isamed93/macropad_4x4_promicro/README.md

# macropad_4x4_promicro
Project for the second version of the 4x4 macropad, which uses a promicro instead of an onboard MCU
