isamed93/macropad_4x4_promicro/streamdeck2.sch

## KiCad design streamdeck2.sch (2022-08-13)

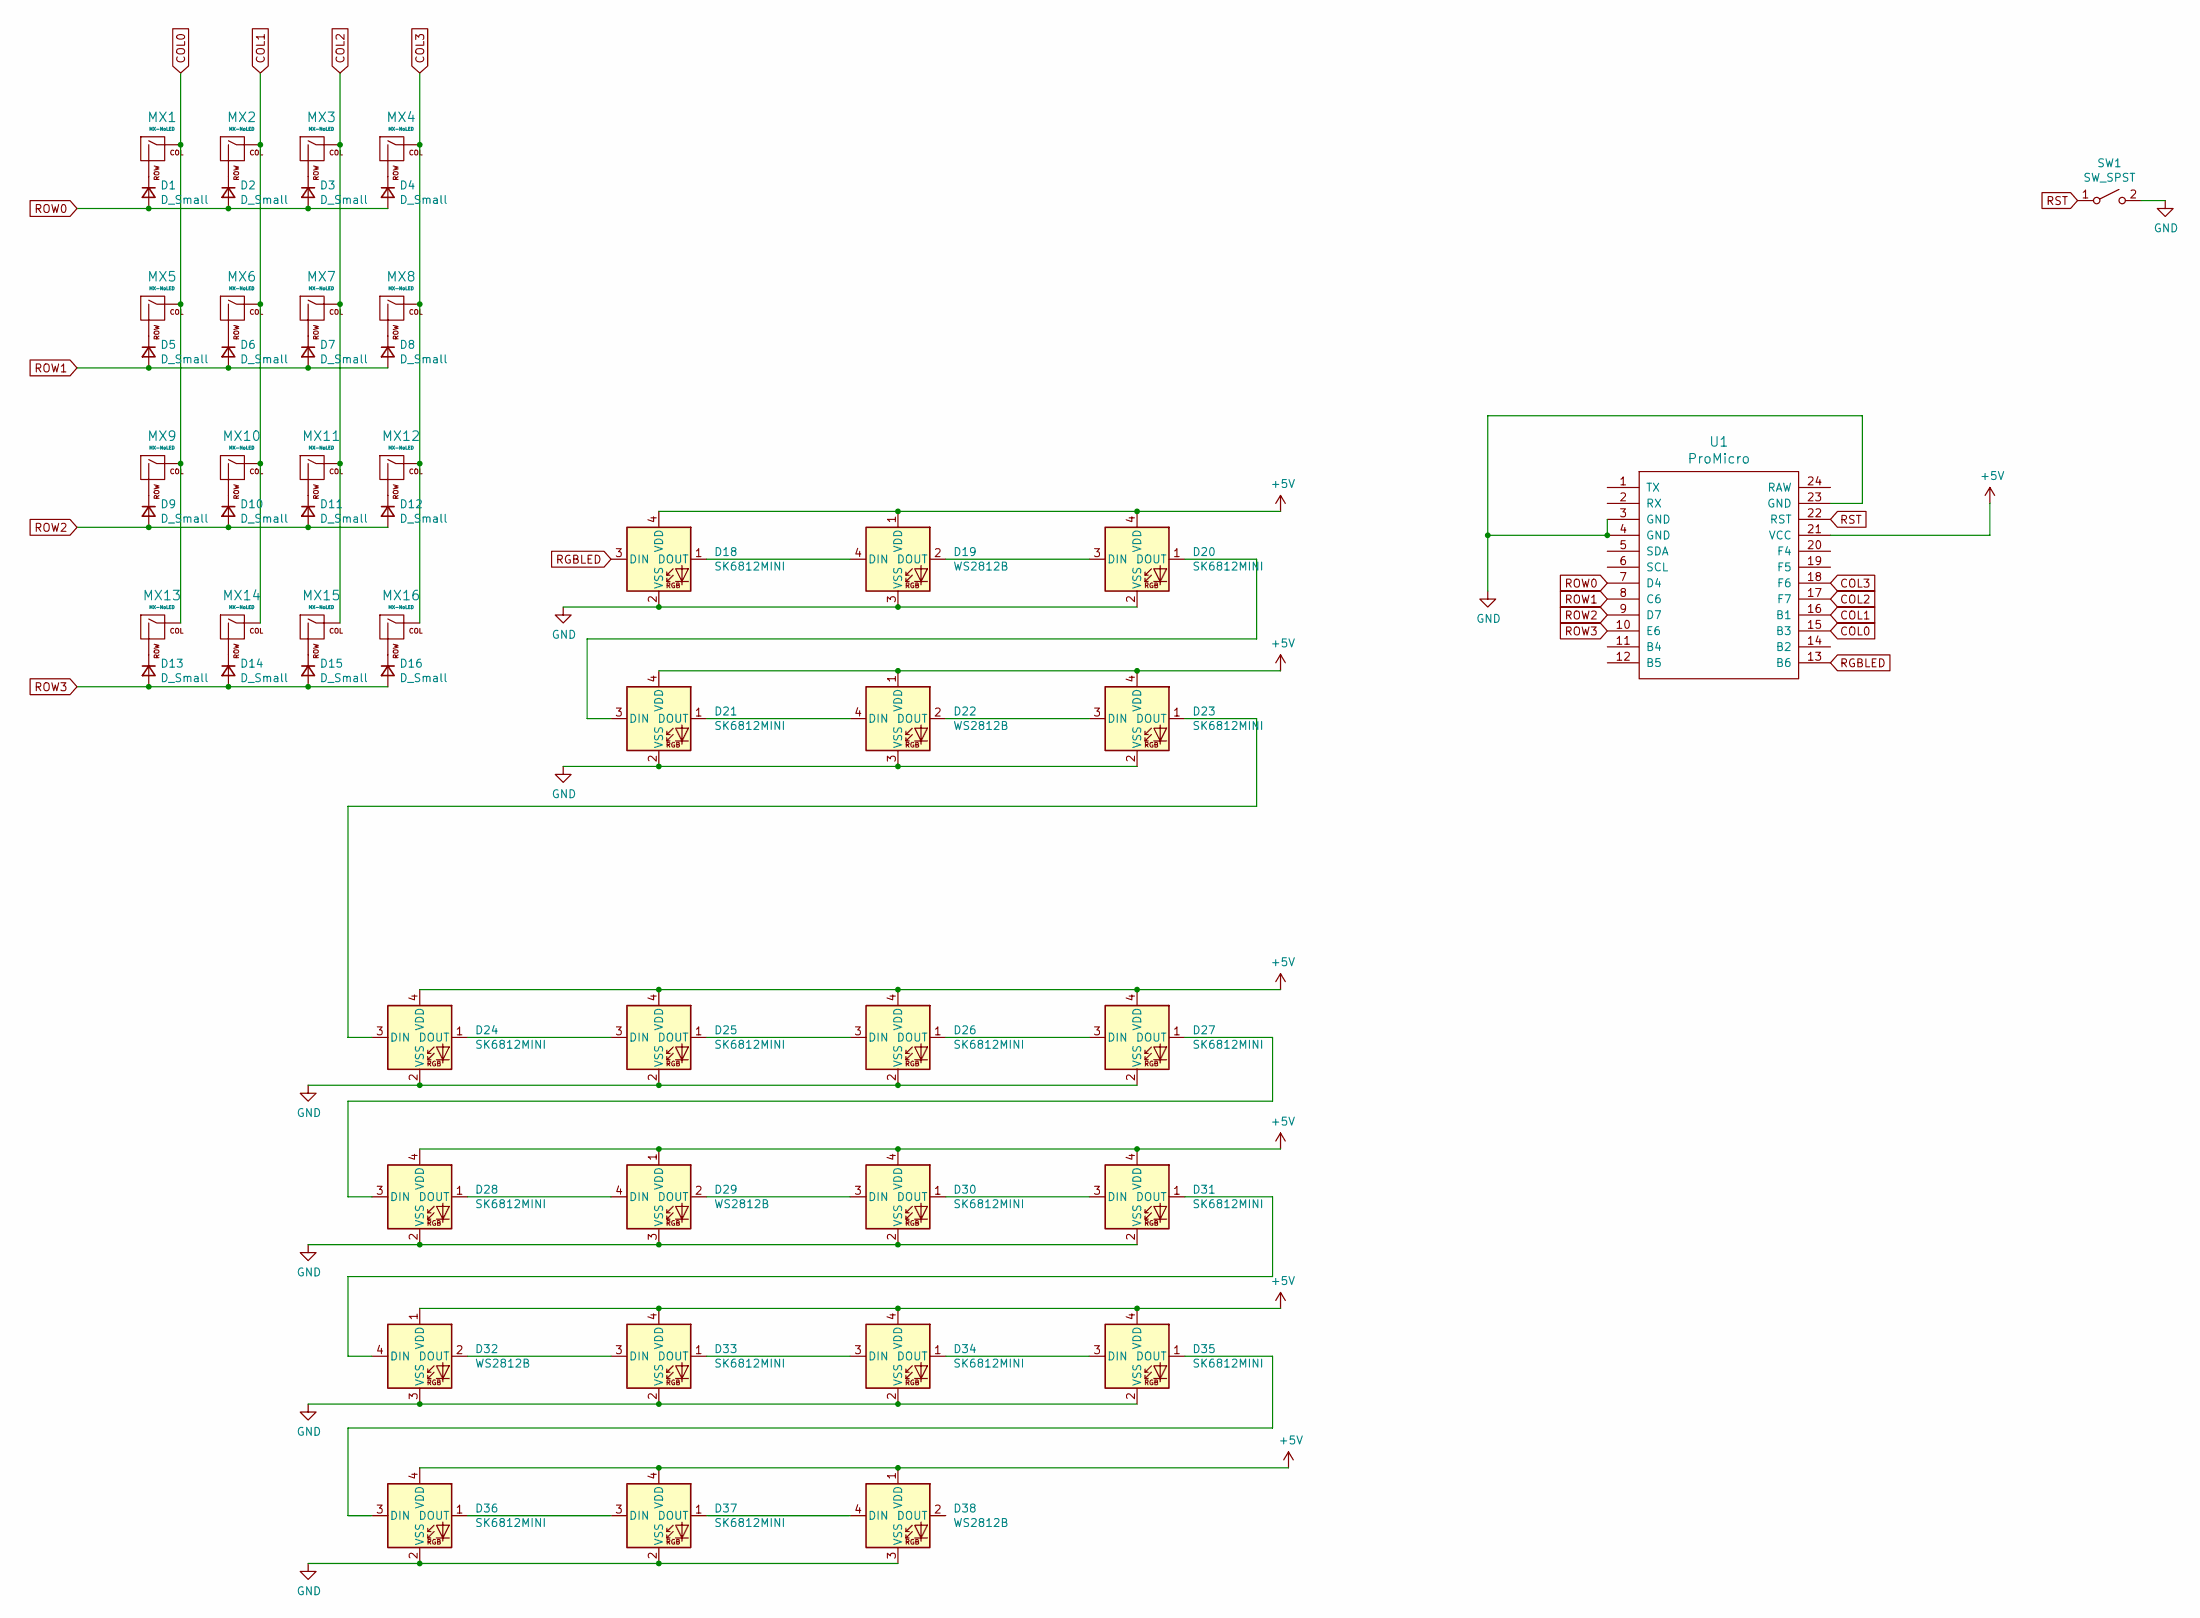
[picture p1: schematic streamdeck2.sch]

Parts:
D1, D2, D3, D4, D5, D6, D7, D8, D9, D10, D11, D12, D13, D14, D15, D16: D_Small; D_SOD-123
D18, D20, D21, D23, D24, D25, D26, D27, D28, D30, D31, D33, D34, D35, D36, D37: SK6812MINI; YS-SK6812MINI-E
D19, D22, D29, D32, D38: WS2812B; LED_WS2812B_PLCC4_5.0x5.0mm_P3.2mm
MX1, MX2, MX3, MX4, MX5, MX6, MX7, MX8, MX9, MX10, MX11, MX12, MX13, MX14, MX15, MX16: MX-NoLED; MXOnly-1U-Hotswap
SW1: SW_SPST; SW_SPST_TL3342
U1: ProMicro

Connections:
+5V: D18.4 (VDD), D19.1 (VDD), D20.4 (VDD), D21.4 (VDD), D22.1 (VDD), D23.4 (VDD), D24.4 (VDD), D25.4 (VDD), D26.4 (VDD), D27.4 (VDD), D28.4 (VDD), D29.1 (VDD), D30.4 (VDD), D31.4 (VDD), D32.1 (VDD), D33.4 (VDD), D34.4 (VDD), D35.4 (VDD), D36.4 (VDD), D37.4 (VDD), D38.1 (VDD), U1.21 (VCC)
COL0: MX1.1 (COL), MX5.1 (COL), MX9.1 (COL), MX13.1 (COL), U1.15 (B3)
COL1: MX2.1 (COL), MX6.1 (COL), MX10.1 (COL), MX14.1 (COL), U1.16 (B1)
COL2: MX3.1 (COL), MX7.1 (COL), MX11.1 (COL), MX15.1 (COL), U1.17 (F7)
COL3: MX4.1 (COL), MX8.1 (COL), MX12.1 (COL), MX16.1 (COL), U1.18 (F6)
GND: D18.2 (VSS), D19.3 (VSS), D20.2 (VSS), D21.2 (VSS), D22.3 (VSS), D23.2 (VSS), D24.2 (VSS), D25.2 (VSS), D26.2 (VSS), D27.2 (VSS), D28.2 (VSS), D29.3 (VSS), D30.2 (VSS), D31.2 (VSS), D32.3 (VSS), D33.2 (VSS), D34.2 (VSS), D35.2 (VSS), D36.2 (VSS), D37.2 (VSS), D38.3 (VSS), SW1.2 (B), U1.3 (GND), U1.4 (GND), U1.23 (GND)
unnamed: D1.1 (K), MX1.2 (ROW)
unnamed: D2.1 (K), MX2.2 (ROW)
unnamed: D3.1 (K), MX3.2 (ROW)
unnamed: D4.1 (K), MX4.2 (ROW)
unnamed: D5.1 (K), MX5.2 (ROW)
unnamed: D6.1 (K), MX6.2 (ROW)
unnamed: D7.1 (K), MX7.2 (ROW)
unnamed: D8.1 (K), MX8.2 (ROW)
unnamed: D9.1 (K), MX9.2 (ROW)
unnamed: D10.1 (K), MX10.2 (ROW)
unnamed: D11.1 (K), MX11.2 (ROW)
unnamed: D12.1 (K), MX12.2 (ROW)
unnamed: D13.1 (K), MX13.2 (ROW)
unnamed: D14.1 (K), MX14.2 (ROW)
unnamed: D15.1 (K), MX15.2 (ROW)
unnamed: D16.1 (K), MX16.2 (ROW)
unnamed: D18.1 (DOUT), D19.4 (DIN)
unnamed: D19.2 (DOUT), D20.3 (DIN)
unnamed: D20.1 (DOUT), D21.3 (DIN)
unnamed: D21.1 (DOUT), D22.4 (DIN)
unnamed: D22.2 (DOUT), D23.3 (DIN)
unnamed: D23.1 (DOUT), D24.3 (DIN)
unnamed: D24.1 (DOUT), D25.3 (DIN)
unnamed: D25.1 (DOUT), D26.3 (DIN)
unnamed: D26.1 (DOUT), D27.3 (DIN)
unnamed: D27.1 (DOUT), D28.3 (DIN)
unnamed: D28.1 (DOUT), D29.4 (DIN)
unnamed: D29.2 (DOUT), D30.3 (DIN)
unnamed: D30.1 (DOUT), D31.3 (DIN)
unnamed: D31.1 (DOUT), D32.4 (DIN)
unnamed: D32.2 (DOUT), D33.3 (DIN)
unnamed: D33.1 (DOUT), D34.3 (DIN)
unnamed: D34.1 (DOUT), D35.3 (DIN)
unnamed: D35.1 (DOUT), D36.3 (DIN)
unnamed: D36.1 (DOUT), D37.3 (DIN)
unnamed: D37.1 (DOUT), D38.4 (DIN)
RGBLED: D18.3 (DIN), U1.13 (B6)
ROW0: D1.2 (A), D2.2 (A), D3.2 (A), D4.2 (A), U1.7 (D4)
ROW1: D5.2 (A), D6.2 (A), D7.2 (A), D8.2 (A), U1.8 (C6)
ROW2: D9.2 (A), D10.2 (A), D11.2 (A), D12.2 (A), U1.9 (D7)
ROW3: D13.2 (A), D14.2 (A), D15.2 (A), D16.2 (A), U1.10 (E6)
RST: SW1.1 (A), U1.22 (RST)
