isamed93/macropad_4x4_promicro/(threads)

Thread 1 (2022-08-27):

Bug: LED footprints

isamed93, 2022-08-27:
The LED footprint used has incorrect terminals that don't match the datasheet of per-key LEDs.
Replace the footprints and retrace copper.

isamed93, 2022-08-28:
Found a working SK6812MINI-E footprint (from Keebio-parts). Replaced all the older footprints.

isamed93, 2022-08-28:
Ignore previous comment - there is confusion over footprints vs datasheet (also the datasheet is ass). Test LEDs using an arduino.
Need to buy solid core wire and need to find Arduino chip and make sure the headers on it aren't effed.

isamed93, 2022-08-28:
The LED footprints were never the issue, it was the symbols on the schematic being SK6812MINI rather than SK6812MINI-E, so the pins were numbered differently.

isamed93, 2022-08-28:
Swapped all the SK6812MINI symbols for SK6812MINI-E ones on the schematic.

isamed93, 2022-08-28:
All LEDs are now in the right place and orientation. Ready to retrace.

isamed93, 2022-08-28:
Retracing falls under this git issue: https://github.com/isamed93/macropad_4x4_promicro/issues/7

Closed 2022-08-28.

Thread 2 (2022-08-27):

Bug: Screw positioning

isamed93, 2022-08-27:
The position of the screws holding the different layers together make for an uneven macropad.
Ensure screws can be put more evenly. Maybe make the middle layer smaller than the other 2.

isamed93, 2022-08-28:
Will do this under https://github.com/isamed93/macropad_4x4_promicro/issues/8

Thread 5 (2022-08-28):

Bug: plate drills

isamed93, 2022-08-28:
Replacing PCB parts caused the plate drills to be replaced with Kailh hotswap sockets. Undo this and possibly fix it so this never happens again.

isamed93, 2022-08-28:
Changed the plate drill references to MX17-MX32. Changed all of their footprints.

Closed 2022-08-28.

Thread 6 (2022-08-28):

Improvement: switch diode orientation

isamed93, 2022-08-28:
All the switch diodes are the wrong way around. Rotate 180 degrees.

isamed93, 2022-08-28:
Done on the schematic, need to update the PCB but it's fucking up the plate drills.

isamed93, 2022-08-28:
???? what even is this ticket

Closed 2022-08-28.

Thread 7 (2022-08-28):

Retrace everything

isamed93, 2022-08-28:
Retrace everything after fixing any issues that involve moving PCB elements around.

isamed93, 2022-08-29:
All traces complete

Closed 2022-08-29.

Thread 9 (2022-08-29):

Feature: Add aluminium feet

isamed93, 2022-08-29:
Add screw holes for putting aluminium feet

isamed93, 2022-08-29:
Screw holes should be 3.8mm, looking at https://flashquark.com/product/aluminum-keyboard-feet-set-of-2/
