isamed93/macropad_4x4_promicro/(commit log)

2022-08-13 Project ready to print
    [streamdeck2-B_Cu.gbr, streamdeck2-B_Mask.gbr, streamdeck2-B_Paste.gbr, streamdeck2-B_SilkS.gbr, streamdeck2-Edge_Cuts.gbr, streamdeck2-F_Cu.gbr, streamdeck2-F_Mask.gbr, streamdeck2-F_Paste.gbr]
2022-08-13 Deleted gerber files from previous version
    [streamdeck2-B_Cu.gbr, streamdeck2-B_Mask.gbr, streamdeck2-B_Paste.gbr, streamdeck2-B_SilkS.gbr, streamdeck2-Edge_Cuts.gbr, streamdeck2-F_Cu.gbr, streamdeck2-F_Mask.gbr, streamdeck2-F_Paste.gbr]
